heethesh/Balance-Bot/schematics/Balance Bot Schematic.pdf

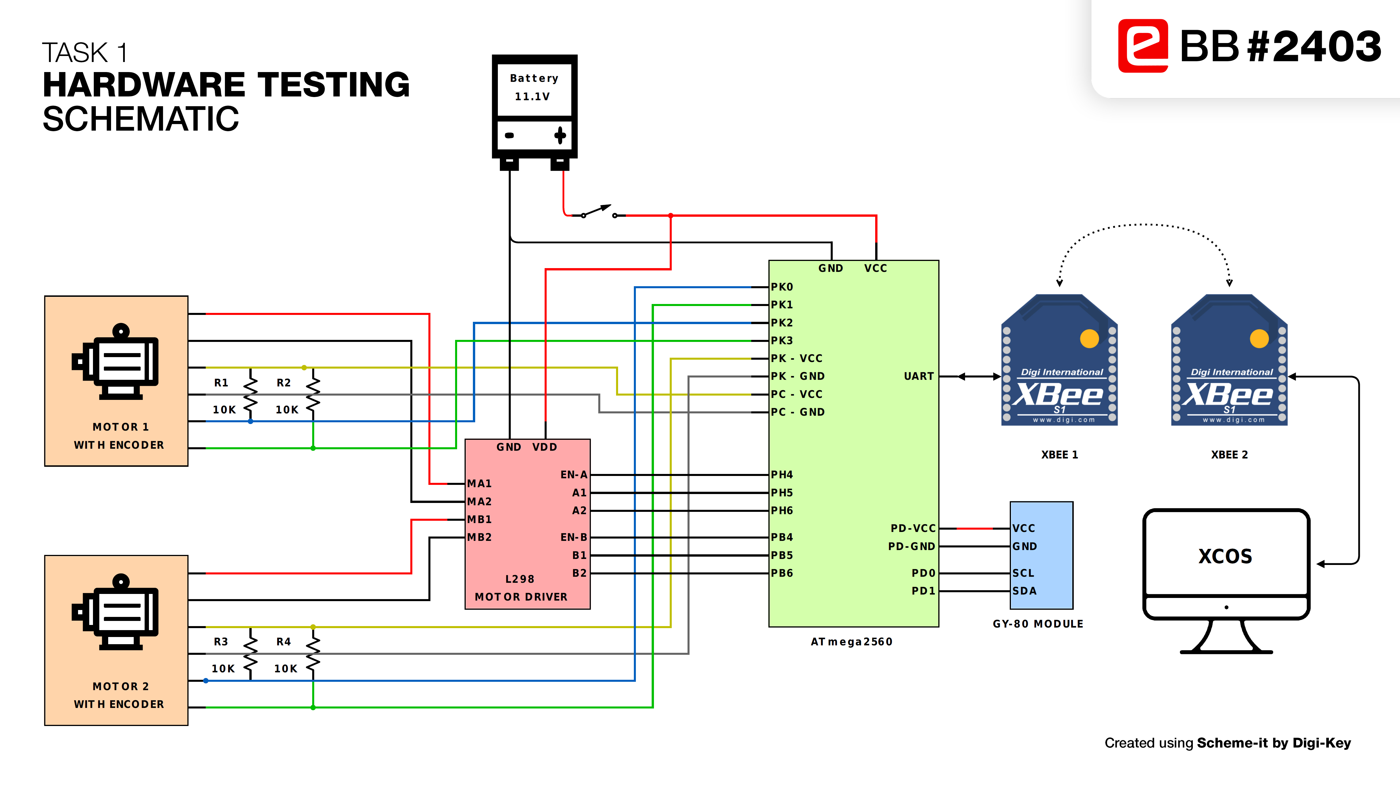
[picture p31: page 1]
