heethesh/Balance-Bot/schematics/Hardware Testing Setup.jpg

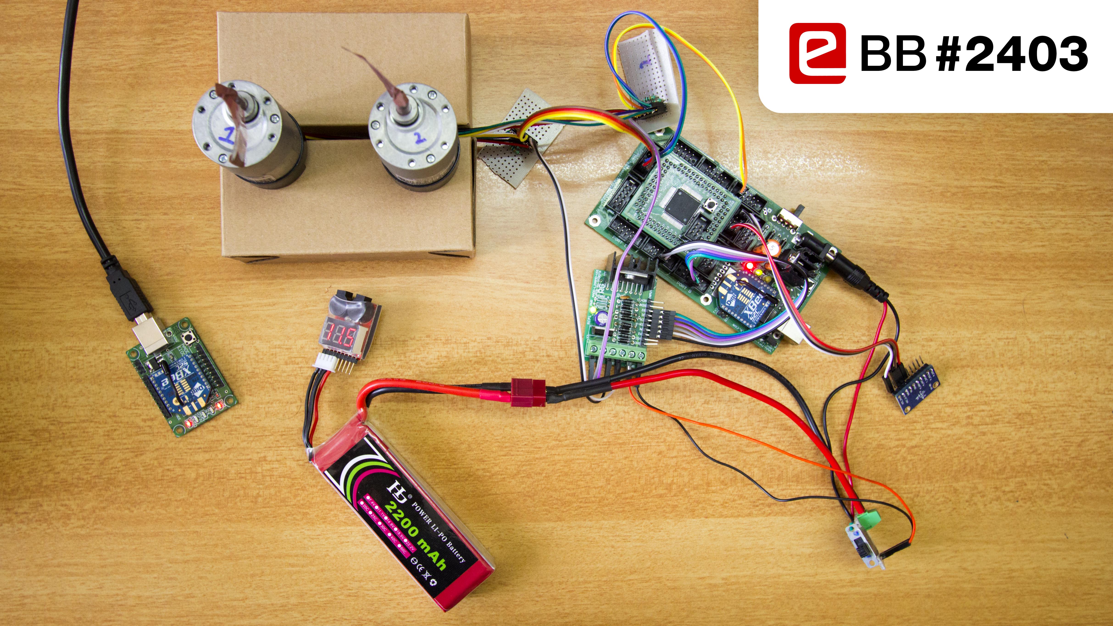
schematics/Hardware Testing Setup.jpg
