heethesh/Balance-Bot/(threads)

Thread 1 (2020-04-10):

Have a error with header files

mhsily, 2020-04-10:
Hello I am student.
I have made separate .cpp files for motors (including encoders), path planning, arm mechanism and one for remaining code. So for main program I have created headers files .h with just declarations of functions and variables.
I have just included header files (.h ) in main program and all the definition  in .cpp.
Error comes if I call function from headers.
See the image attached you will understand everything.
Giude me where the problem is.
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

heethesh, 2020-04-10:
There is no `lcd_pin_config` in my source code. You have to fix this yourself.

heethesh, 2020-04-10:
This does not even look like an issue with this repository.

Closed 2020-04-10.
