heethesh/Balance-Bot/code/Tones/pitches.h

// ---------------------------------------------------------------------------
// AnyRtttl Library - v2.1 - 06/05/2016
// Copyright (C) 2016 Antoine Beauchamp
// The code & updates for the library can be found on http://end2endzone.com
//
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
// DISCLAIMER:
//  This software is furnished "as is", without technical support, and with no
//  warranty, express or implied, as to its usefulness for any purpose.
//
// PURPOSE:
//  After publishing my NonBlockingRtttl arduino library, I started using the
//  library in more complex projects which was requiring other libraries.
//  I quickly ran into the hell of library dependencies and library conflicts.
//  I realized that I needed more features that could help me prototype faster.
//
//  Other libraries available which allows you to play a melody in RTTTL format
//  suffer the same issue: they are based on blocking APIs or the RTTTL data is
//  not optimized for space.
//
//  AnyRtttl is different since it packs multiple RTTTL related features in a
//  single library. It supports blocking & non-blocking API which makes it
//  suitable to be used by more advanced algorithm. For instance, when using
//  the non-blocking API, the melody can be stopped when a button is pressed.
//  The library is also compatible with external Tone libraries and supports
//  highly compressed RTTTL binary formats.
//
// USAGE:
//  The library has multiple examples which shows how to use the library with
//  each features. Refers the to examples details. More information is also
//  available on the project's home page: http://end2endzone.com.
//
//  Define ANY_RTTTL_INFO to enable the debugging of the library state
//  on the serial port.
//
//  Use ANY_RTTTL_VERSION to get the current version of the library.
//
// HISTORY:
// 03/19/2016 v1.0 - Initial release of NonBlockingRtttl.
// 05/21/2016 v2.0 - Library converted to AnyRtttl.
// 06/05/2016 v2.1 - Implemented support for RTTTL in Program Memory (PROGMEM).
//
// ---------------------------------------------------------------------------

#ifndef PITCHES_H
#define PITCHES_H

/*************************************************
* Notes Constants
*************************************************/
#define NOTE_REST   0
#define NOTE_SILENT 0

#define NOTE_C0  16
#define NOTE_CS0 17
#define NOTE_D0  18
#define NOTE_DS0 19
#define NOTE_E0  21
#define NOTE_F0  22
#define NOTE_FS0 23
#define NOTE_G0  24
#define NOTE_GS0 26
#define NOTE_A0  28
#define NOTE_AS0 29
#define NOTE_B0  31
#define NOTE_C1  33
#define NOTE_CS1 35
#define NOTE_D1  37
#define NOTE_DS1 39
#define NOTE_E1  41
#define NOTE_F1  44
#define NOTE_FS1 46
#define NOTE_G1  49
#define NOTE_GS1 52
#define NOTE_A1  55
#define NOTE_AS1 58
#define NOTE_B1  62
#define NOTE_C2  65
#define NOTE_CS2 69
#define NOTE_D2  73
#define NOTE_DS2 78
#define NOTE_E2  82
#define NOTE_F2  87
#define NOTE_FS2 93
#define NOTE_G2  98
#define NOTE_GS2 104
#define NOTE_A2  110
#define NOTE_AS2 117
#define NOTE_B2  123
#define NOTE_C3  131
#define NOTE_CS3 139
#define NOTE_D3  147
#define NOTE_DS3 156
#define NOTE_E3  165
#define NOTE_F3  175
#define NOTE_FS3 185
#define NOTE_G3  196
#define NOTE_GS3 208
#define NOTE_A3  220
#define NOTE_AS3 233
#define NOTE_B3  247
#define NOTE_C4  262
#define NOTE_CS4 277
#define NOTE_D4  294
#define NOTE_DS4 311
#define NOTE_E4  330
#define NOTE_F4  349
#define NOTE_FS4 370
#define NOTE_G4  392
#define NOTE_GS4 415
#define NOTE_A4  440
#define NOTE_AS4 466
#define NOTE_B4  494
#define NOTE_C5  523
#define NOTE_CS5 554
#define NOTE_D5  587
#define NOTE_DS5 622
#define NOTE_E5  659
#define NOTE_F5  698
#define NOTE_FS5 740
#define NOTE_G5  784
#define NOTE_GS5 831
#define NOTE_A5  880
#define NOTE_AS5 932
#define NOTE_B5  988
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
#define NOTE_FB8 NOTE_ES8
#define NOTE_GB8 NOTE_FS8
#define NOTE_AB8 NOTE_GS8
#define NOTE_BB9 NOTE_AS9
#define NOTE_CB9 NOTE_BS9
#define NOTE_DB9 NOTE_CS9
#define NOTE_EB9 NOTE_DS9
#define NOTE_FB9 NOTE_ES9
#define NOTE_GB9 NOTE_FS9
#define NOTE_AB9 NOTE_GS9

#endif //PITCHES_H
