heethesh/Balance-Bot/(notices)

Notices in the files:
code/Tones/anyrtttl.cpp:
AUTHOR/LICENSE:
This library is free software; you can redistribute it and/or
